FernandoBichuette/projeto-mecat/Anexos/Fotos PCB/Step-Down.jpeg

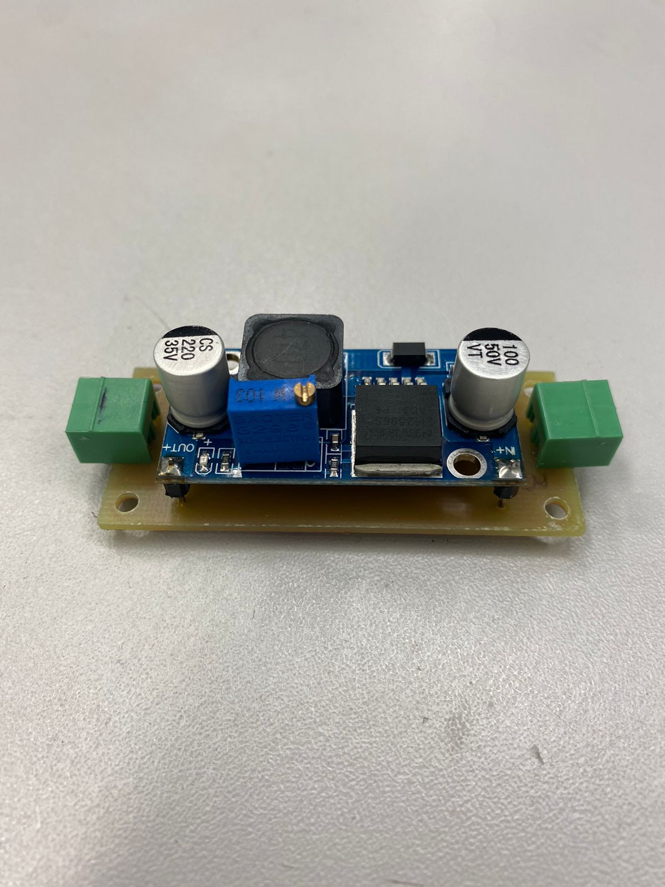
Anexos/Fotos PCB/Step-Down.jpeg
