FernandoBichuette/projeto-mecat/Anexos/Fotos PCB/Lógica Combinacional.jpeg

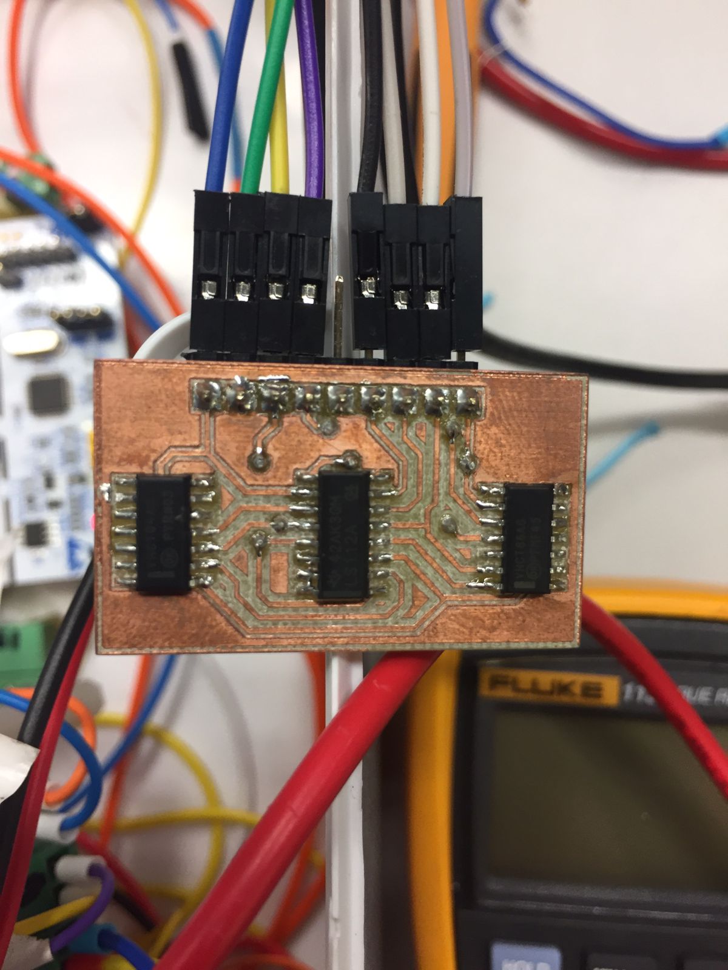
Anexos/Fotos PCB/Lógica Combinacional.jpeg
