FernandoBichuette/projeto-mecat/README.md

  # Projeto Mecatrônico

O projeto mecatrônico da INSPER envolve a criação de uma máquina pipetadora automática destinada a laboratórios, com o intuito de otimizar e tornar mais preciso o processo de pipetagem. A equipe responsável pelo projeto abordou as áreas de Mecânica, Eletrônica e Software para desenvolver um protótipo funcional que atendesse aos requisitos estabelecidos.

Na parte mecânica do projeto, foram realizados cálculos detalhados para o dimensionamento de componentes essenciais, como o fuso de esferas e mancais, guia linear e carro. Esses cálculos foram fundamentais para garantir a correta seleção e integração dos componentes mecânicos, visando a eficiência e durabilidade da máquina pipetadora.

No âmbito eletrônico, o projeto contou com a utilização de diversos elementos, como a placa núcleo com o microcontrolador STM32F103RB, responsável por enviar sinais e alimentar componentes, o debouncing para estabilização de chaves mecânicas, o step-down para conversão de tensão, além dos acionamentos da pipeta e dos motores nos eixos X, Y e Z. Esses componentes eletrônicos foram integrados de forma a garantir o correto funcionamento e controle da máquina.

O desenvolvimento do software do projeto foi baseado em fluxogramas detalhados, que descrevem as operações e funcionalidades da máquina pipetadora. A programação do software foi realizada de acordo com esses fluxogramas, visando a automação e precisão das tarefas executadas pela máquina.

O processo de desenvolvimento do protótipo funcional seguiu as etapas convencionais do processo de desenvolvimento de produto (PDP), envolvendo desde o dimensionamento mecânico e fabricação de peças até o desenvolvimento do projeto eletro-eletrônico, programação de software e implementação da interface homem-máquina.

Em suma, o projeto mecatrônico da INSPER representa um esforço integrado para criar uma máquina pipetadora automática de alta precisão e eficiência, combinando conhecimentos de Mecânica, Eletrônica e Software para atender às demandas de automação no ambiente laboratorial.
