FernandoBichuette/projeto-mecat/Anexos/Fluxogramas e código/codigo fonte.docx

#include "mbed.h"

#include "TextLCD.h"

#include <cstdio>

#include <new>

#include <vector>

// Host PC Communication channels

Serial pc(USBTX, USBRX); // tx, rx

// I2C Communication

I2C i2c_lcd(I2C_SDA, I2C_SCL); // SDA, SCL >>> NUCLEO: D14,D15

//I2C Portexpander PCF8574

TextLCD_I2C lcd(&i2c_lcd, 0x7E, TextLCD::LCD20x4); // I2C bus, PCF8574 Slaveaddress, LCD Type Original = 0x42, Usando I2C scanner = 0x3F

//define quais portas serão usadas e o que farão

DigitalOut clk(PB_15); //step

InterruptIn botao_confirma(PA_11); //botão confirma/verde

InterruptIn botao_chega(PB_6); //botão start cycle/vermelho

InterruptIn botao_emergencia(PA_10); //botão de emergencia

InterruptIn sensor_x_1(PC_9); //sensor de fim de curso em x

DigitalIn x_mais(PB_4); //botão de x+

DigitalIn x_menos(PB_3); //botão de x-

DigitalOut enable_x(PC_5);//enable em x

DigitalOut clkwise_x(PC_6);//direção em x

InterruptIn sensor_y_1(PB_7); //sensor de fim de curso em y

DigitalIn y_mais(PB_10);//botão de y+

DigitalIn y_menos(PA_8);//botão de y-

DigitalOut enable_y(PB_12);//enable em y

DigitalOut clkwise_y(PB_11);//direção em y

InterruptIn sensor_z_1(PA_12); //sensor de fim de curso em y

DigitalIn z_menos(PC_7); //botão de z-

DigitalIn z_mais(PA_9);//botão de z+

DigitalOut enable_z(PB_13);//enable em z

DigitalOut clkwise_z(PB_14);//direção em z

DigitalOut pipeta(PC_4); //pipeta

//Variaveis usadas

int tempo = 950;

int ola;

int quantos_depositos;

int confirma1;

int pote;

int volume;

int index;

int referenciar;

int ciclo;

int fim_referenciamento;

int fc;

int jog;

int ciclo_emergencia;

int voltar_origem;

int curso_x = 49019;

int referenciar_x;

int fonte_x;

int deposito_x=0;

int curso_y=17220;

int referenciar_y;

int fonte_y;

int deposito_y;

int curso_z = 7450;

int referenciar_z;

int fonte_z;

int deposito_z;

int n;

int define_volume;

int define_posicao;

int x1;

int x2;

int x3;

int y1;

int y2;

int y3;

int z1;

int z2;

int z3;

int v1;

int v2;

int v3;

int erro;

void vermelho(){ //Rotina de interrupção que inicializa o ciclo automatico (start cycle)

if(index>1){

ciclo=9;

}

}

void emergencia(){ //Rotina de interrupção da emergencia

erro=!erro;

if(erro==0){

NVIC_SystemReset(); //reseta o programa

}

}

void fim_de_curso_z_1(){ //Rotina de interrupção do fim de curso em z

switch (fc) {

case 0:

referenciar=2;

clkwise_z=0;

for(int i=0;i<400;i++){

enable_z=0;

clk=!clk;

wait_us(tempo);

}

fc++;

enable_z=1;

break;

}

switch (ciclo) {

case 0:

enable_x=1;

enable_y=1;

enable_z=0;

for(int i=0;i<400;i++){

clkwise_z=1;

clk=!clk;

wait_us(tempo);

}

break;

}

}

void fim_de_curso_y_1(){ //Rotina de interrupção do fim de curso em y

switch (fc) {

case 1:

referenciar=3;

clkwise_y=0;

for(int i=0;i<400;i++){

clk=!clk;

wait_us(tempo);

}

fc++;

enable_y=1;

break;

}

switch (ciclo) {

case 0:

enable_y=0;

enable_x=1;

clkwise_y=1;

for(int i=0;i<400;i++){

clkwise_y=0;

clk=!clk;

wait_us(tempo);

}

break;

}

}

void fim_de_curso_x_1(){ //Rotina de interrupção do fim de curso em x

switch (fc) {

case 2:

referenciar=4;

clkwise_x=1;

for(int i=0;i<400;i++){

enable_x=0;

clk=!clk;

wait_us(tempo);

}

fc++;

fim_referenciamento=1;

enable_x=1;

break;

}

switch (ciclo) {

case 0:

enable_y=1;

enable_x=0;

for(int i=0;i<400;i++){

clkwise_x=1;

clk=!clk;

wait_us(tempo);

}

break;

}

}

void confirma(){ //Rotina de interrupção do botão de confirmação

if (referenciar==0){

referenciar=1;

ciclo = 1;

}

if (fim_referenciamento==1){

referenciar=0;

ciclo=2;

}

if (jog ==1){

ciclo=3;

}

if(define_volume==1){

ciclo=4;

}

if(define_volume==2){

ciclo=5;

}

if(define_volume==3){

ciclo=6;

}

if(define_volume==4){

ciclo=7;

}

if(define_volume==5){

ciclo=8;

}

if(define_volume==6){

ciclo=9;

}

}

int main(){

//define em quais funções os botoes vão entrar

botao_confirma.fall(&confirma);

botao_chega.fall(&vermelho);

botao_emergencia.rise(&emergencia);

sensor_x_1.fall(&fim_de_curso_x_1);

sensor_y_1.fall(&fim_de_curso_y_1);

sensor_z_1.fall(&fim_de_curso_z_1);

//liga o lcd

lcd.setBacklight(TextLCD::LightOn);

//inicia o programas com os motores desligados

enable_x=1;

enable_y=1;

enable_z=1;

volume = 0;

pipeta =1;

while(1){//loop principal

switch(erro){

case 1:

while(erro==1){ //loop para aparecer no lcd a messagem emergencia, caso botão do acionado

lcd.cls();

lcd.locate(4,2);

lcd.printf("Emergencia");

wait(3);

}

break;

}

switch (ciclo) { //Ciclo do programa do ciclo total

case 0:

while(ciclo==0 && jog==0){ //loop para aparecer no lcd a messagem de intruções iniciais

lcd.cls();

wait_us(10);

lcd.cls();

lcd.locate(8,1);

lcd.printf("Ola");

wait(3);

lcd.cls();

wait_us(10);

lcd.cls();

lcd.locate(3,1);

lcd.printf("Aperte confirma");

lcd.locate(3,2);

lcd.printf("para iniciar o");

lcd.locate(3,3);

lcd.printf("referenciamento");

wait(4);

}

break;

case 1: // rotina de referenciamento em todos os eixos

lcd.cls();

wait_us(10);

lcd.cls();

lcd.locate(2,1);

lcd.printf("Referenciando...");

switch (referenciar) {

case 1:

enable_z=0;

clkwise_z=1;

while(referenciar==1){

clk=!clk;

wait_us(tempo);

}

break;

case 2:

enable_y=0;

clkwise_y=1;

while(referenciar==2){

clk=!clk;

wait_us(tempo);

}

break;

case 3:

enable_x=0;

clkwise_x=0;

while(referenciar==3){

clk=!clk;

wait_us(tempo);

}

break;

case 4:

while(referenciar==4){

lcd.cls();

wait_us(10);

lcd.cls();

lcd.locate(2,1);

lcd.printf("Referenciamento");

lcd.locate(5,2);

lcd.printf("concluido");

wait(3);

lcd.cls();

wait_us(10);

lcd.cls();

lcd.locate(3,1);

lcd.printf("Aperte confirma");

lcd.locate(2,2);

lcd.printf("para definir a");

lcd.locate(8,3);

lcd.printf("fonte");

wait(3);

}

break;

}

break;

case 2: //Rotina de jog para fonte/reservatorio de liquido

while(ciclo==2){

jog=1;

enable_x=1;

enable_y=1;

enable_z=1;

lcd.cls();

lcd.locate(2,1);

lcd.printf("Fonte X %i",fonte_x);

lcd.locate(2,2);

lcd.printf("Fonte Y %i",fonte_y);

lcd.locate(2,3);

lcd.printf("Fonte Z %i",fonte_z);

wait(0.4);

while(x_mais==0){

if(fonte_x<curso_x){

enable_x=0;

fonte_x++;

clkwise_x=1;

clk=!clk;

wait_us(tempo);

}

else{

enable_x=1;

}

}

while(x_menos==0){

if(fonte_x>0){

enable_x=0;

fonte_x--;

clkwise_x=0;

clk=!clk;

wait_us(tempo);

}

else{

enable_x=1;

}

}

while(y_mais==0){

if(fonte_y<curso_y){

enable_y=0;

fonte_y++;

clkwise_y=0;

clk=!clk;

wait_us(tempo);

}

else{

enable_y=1;

}

}

while(y_menos==0){

if(fonte_y>0){

enable_y=0;

fonte_y--;

clkwise_y=1;

clk=!clk;

wait_us(tempo);

}

else{

enable_y=1;

}

}

//

while(z_menos==0){

if(fonte_z<curso_z){

enable_z=0;

fonte_z++;

clkwise_z=0;

clk=!clk;

wait_us(tempo);

}

else{

enable_z=1;

}

}

while(z_mais==0){

if(fonte_z>0){

enable_z=0;

fonte_z--;

clkwise_z=1;

clk=!clk;

wait_us(tempo);

}

else{

enable_z=1;

}

}

}

break;

case 3:

if(voltar_origem == 0){ //rotina para que depois de definido qual posição da fonte/reservatorio, maquina volta para origem

lcd.cls();

lcd.locate(3,1);

lcd.printf("Voltando para");

lcd.locate(5,2);

lcd.printf("a origem");

for(int z=0; z<(fonte_z);z++){

enable_x=1;

enable_y=1;

enable_z=0;

clkwise_z=1;

clk=!clk;

wait_us(tempo);

}

for(int x=0; x<(fonte_x);x++){

enable_x=0;

enable_y=1;

enable_z=1;

clkwise_x=0;

clk=!clk;

wait_us(tempo);

}

for(int y=0; y<(fonte_y);y++){

enable_x=1;

enable_y=0;

enable_z=1;

enable_y=0;

clkwise_y=1;

clk=!clk;

wait_us(tempo);

}

voltar_origem=1;

}

if (voltar_origem==1){ //rotina para definir volume no pote 1

lcd.cls();

lcd.locate(3,1);

lcd.printf("Defina o volume");

lcd.locate(3,2);

lcd.printf("no pote %i",index);

lcd.locate(3,3);

lcd.printf("%i ml",v1);

index++;

define_volume++;

while(ciclo==3){ //loop para definir volume no pote 1

lcd.cls();

lcd.locate(3,1);

lcd.printf("Defina o volume");

lcd.locate(3,2);

lcd.printf("no pote %i",index);

lcd.locate(3,3);

lcd.printf("%i ml",v1);

wait(0.8);

while(z_mais==0){

v1++;

wait(0.2);

}

while(z_menos==0){

if(v1>=0){

v1--;

wait(0.2);

}

}

}

}

break;

////

case 4: //rotina para definir posição do pote 1

lcd.cls();

wait_us(10);

lcd.cls();

lcd.locate(3,1);

lcd.printf("Deposito X %i",x1);

lcd.locate(3,2);

lcd.printf("Deposito Y %i",y1);

lcd.locate(3,3);

lcd.printf("Deposito Z %i",z1);

define_volume++;

while(ciclo==4){

enable_x=1;

enable_y=1;

enable_z=1;

lcd.cls();

wait_us(10);

lcd.cls();

lcd.locate(3,1);

lcd.printf("Deposito X %i",x1);

lcd.locate(3,2);

lcd.printf("Deposito Y %i",y1);

lcd.locate(3,3);

lcd.printf("Deposito Z %i",z1);

wait(0.8);

while(x_mais==0){

if(x1<curso_x){

enable_x=0;

clkwise_x=1;

x1 ++;

clk=!clk;

wait_us(tempo);

}

else{

enable_x=1;

}

}

while(x_menos==0){

if(x1>0){

enable_x=0;

clkwise_x=0;

x1--;

clk=!clk;

wait_us(tempo);

}

else{

enable_x=1;

}

}

while(y_mais==0){

if(y1<curso_y){

enable_y=0;

clkwise_y=0;

y1 ++;

clk=!clk;

wait_us(tempo);

}

else{

enable_y=1;

}

}

while(y_menos==0){

if(y1>0){

enable_y=0;

clkwise_y=1;

y1--;

clk=!clk;

wait_us(tempo);

}

else{

enable_y=1;

}

}

while(z_menos==0){

if(z1<curso_z){

enable_z=0;

clkwise_z=0;

z1 ++;

clk=!clk;

wait_us(tempo);

}

else{

enable_z=1;

}

}

while(z_mais==0){

if(z1>0){

enable_z=0;

clkwise_z=1;

z1--;

clk=!clk;

wait_us(tempo);

}

else{

enable_z=1;

}

}

}

break;

case 5: //rotina para definir volume no pote 2

lcd.cls();

lcd.locate(3,1);

lcd.printf("Defina o volume");

lcd.locate(3,2);

lcd.printf("no pote %i",index);

lcd.locate(3,3);

lcd.printf("%i ml",v2);

index++;

define_volume++;

while(ciclo==5){

lcd.cls();

lcd.locate(3,1);

lcd.printf("Defina o volume");

lcd.locate(3,2);

lcd.printf("no pote %i",index);

lcd.locate(3,3);

lcd.printf("%i ml",v2);

wait(0.8);

while(z_mais==0){

v2++;

wait(0.2);

}

while(z_menos==0){

if(v2>=0){

v2--;

wait(0.2);

}

}

}

break;

////

case 6: //rotina para definir posição do pote 2

x2=x1;

y2=y1;

z2=z1;

lcd.cls();

wait_us(10);

lcd.cls();

lcd.locate(3,1);

lcd.printf("Deposito X %i",x2);

lcd.locate(3,2);

lcd.printf("Deposito Y %i",y2);

lcd.locate(3,3);

lcd.printf("Deposito Z %i",z2);

define_volume++;

while(ciclo==6){

enable_x=1;

enable_y=1;

enable_z=1;

lcd.cls();

wait_us(10);

lcd.cls();

lcd.locate(3,1);

lcd.printf("Deposito X %i",x2);

lcd.locate(3,2);

lcd.printf("Deposito Y %i",y2);

lcd.locate(3,3);

lcd.printf("Deposito Z %i",z2);

wait(0.8);

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

enable_x=0;

enable_y=1;

enable_z=1;

if ((fonte_x-x1)<0){

clkwise_x=1;

}

else{

clkwise_x=0;

}

clk=!clk;

wait_us(tempo);

}

wait(0.2);

for(int n=0;n<=abs(fonte_y-y1);n++){

enable_x=1;

enable_y=0;

enable_z=1;

if ((fonte_y-y1)<0){

clkwise_y=0;

}

else{

clkwise_y=1;

}

clk=!clk;

wait_us(tempo);

}

wait(0.2);

for(int n=0;n<=z1;n++){

enable_x=1;

enable_y=1;

enable_z=0;

clkwise_z=0;

clk=!clk;

wait_us(tempo);

}

wait(0.2);

pipeta=!pipeta; //aciona a pipeta

wait(4);

for(int n=0;n<=z1;n++){

enable_x=1;

enable_y=1;

enable_z=0;

clkwise_z=1;

clk=!clk;

wait_us(tempo);

//pipeta=!pipeta;

}

wait(0.2);

for(int n=0;n<=abs(fonte_x-x1);n++){

enable_x=0;

enable_y=1;

enable_z=1;

if ((fonte_x-x1)<0){

clkwise_x=1;

}

else{

clkwise_x=0;

}

clk=!clk;

wait_us(tempo);

}

wait(0.2);

for(int n=0;n<=abs(fonte_y-y1);n++){

enable_x=1;

enable_y=0;

enable_z=1;

if ((fonte_y-y1)<0){

clkwise_y=0;

}

else{

clkwise_y=1;

}

clk=!clk;

wait_us(tempo);

}

wait(0.2);

}

}

//messagem de ciclo concluido

lcd.cls();

wait_us(10);

lcd.cls();

lcd.locate(3,1);

lcd.printf("Ciclo");

lcd.locate(3,2);

lcd.printf("Concluido");

wait(0.5);

break;

}

}

}
