FernandoBichuette/projeto-mecat/Anexos/Desenhos Técnicos/Desenho técnico botão.jpg

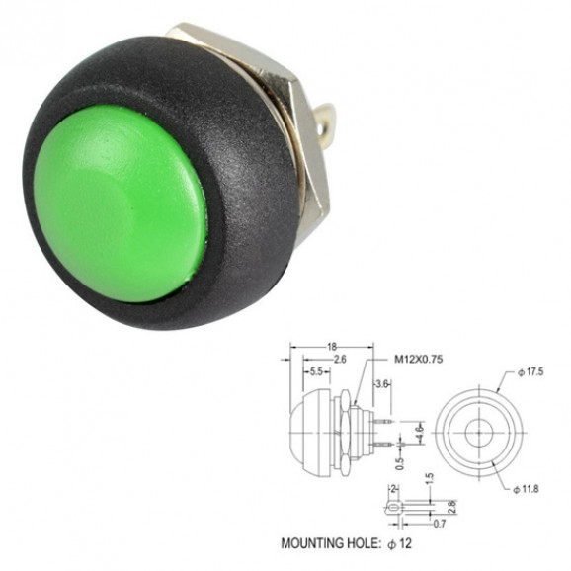
Anexos/Desenhos Técnicos/Desenho técnico botão.jpg
