FernandoBichuette/projeto-mecat/Anexos/Desenhos Técnicos/Desenho Técnico Chave fim de curso.png

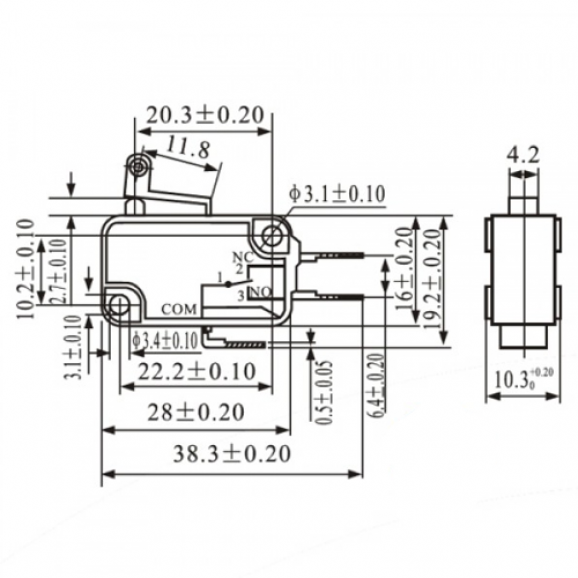
Anexos/Desenhos Técnicos/Desenho Técnico Chave fim de curso.png
