FernandoBichuette/projeto-mecat/Anexos/Fixação da pipeta.jpeg

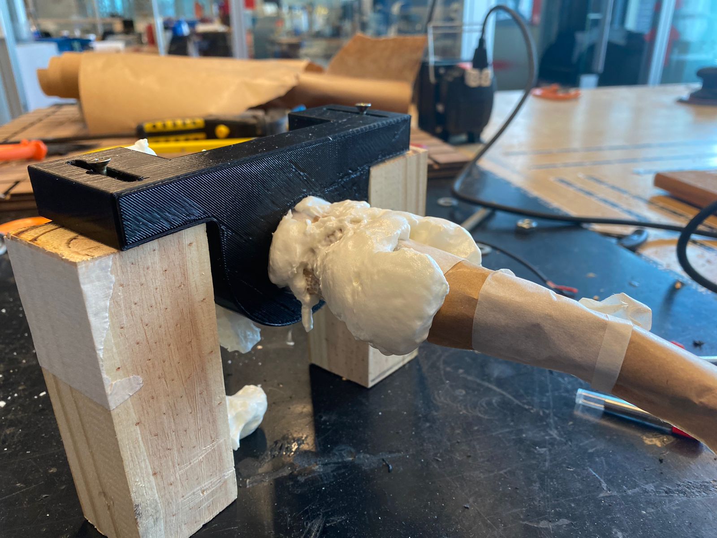
Anexos/Fixação da pipeta.jpeg
