FernandoBichuette/projeto-mecat/Anexos/Fluxogramas e código/Botão de emergência.png

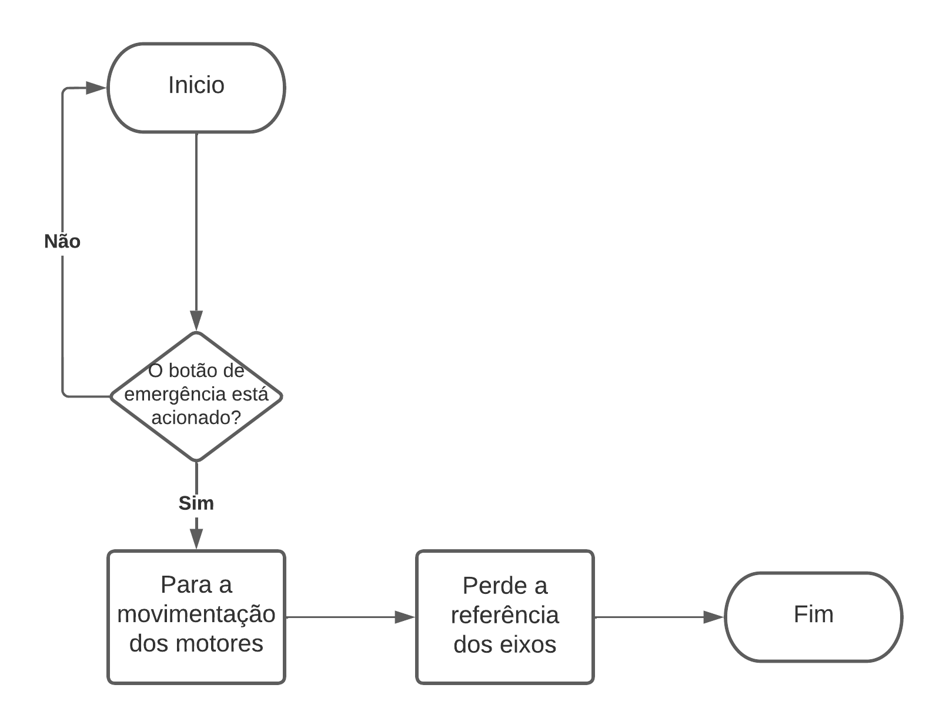
Anexos/Fluxogramas e código/Botão de emergência.png
