FernandoBichuette/projeto-mecat/Anexos/Fluxogramas e código/Ciclo automatico.png

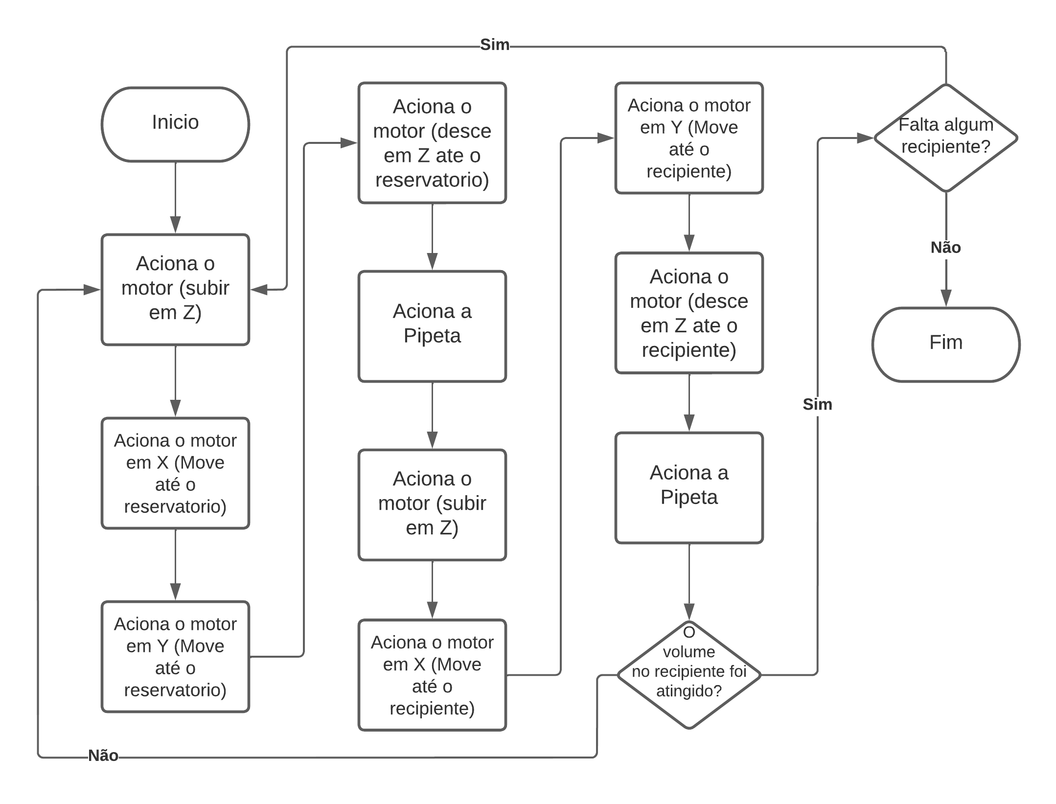
Anexos/Fluxogramas e código/Ciclo automatico.png
