FernandoBichuette/projeto-mecat/Anexos/Fluxogramas e código/Fluxograma Definição de volume.png

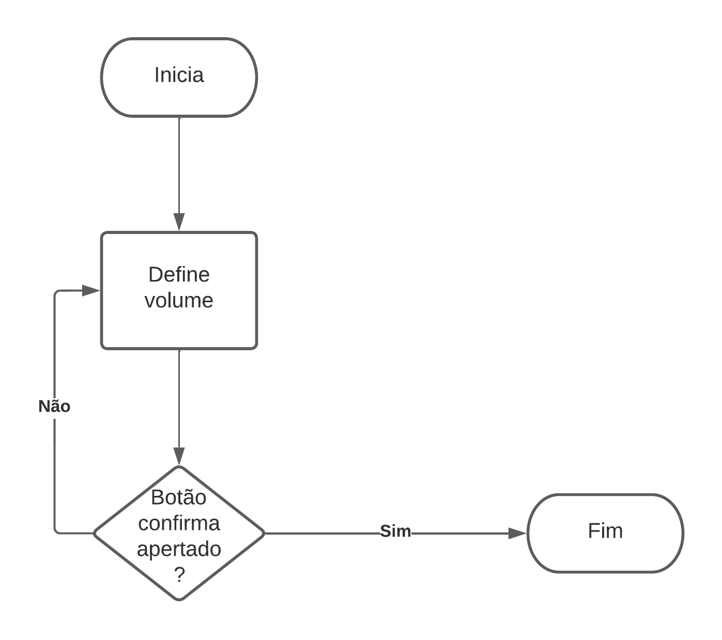
Anexos/Fluxogramas e código/Fluxograma Definição de volume.png
