FernandoBichuette/projeto-mecat/Anexos/Fluxogramas e código/Fluxograma Jog deposito.png

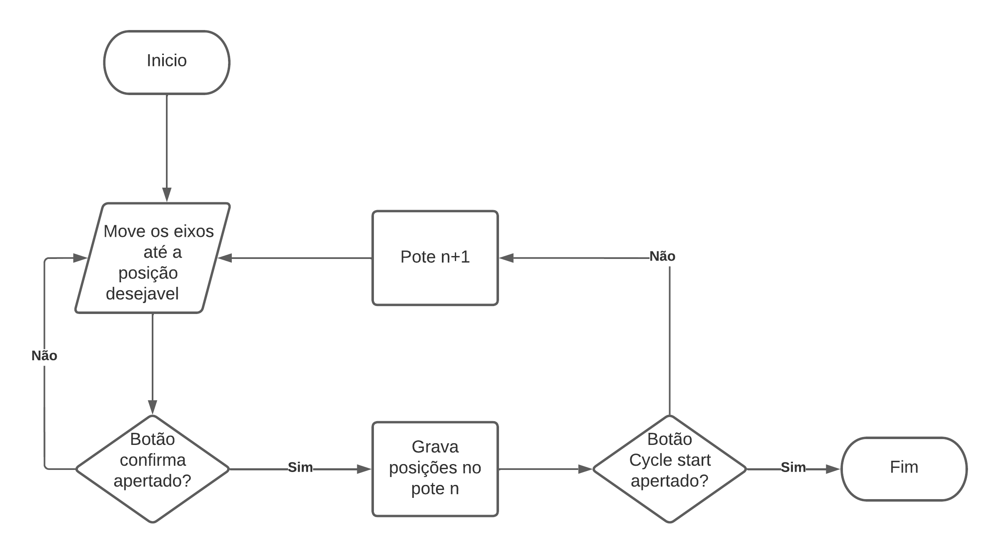
Anexos/Fluxogramas e código/Fluxograma Jog deposito.png
