FernandoBichuette/projeto-mecat/Anexos/Fluxogramas e código/Fluxograma Jog fonte.png

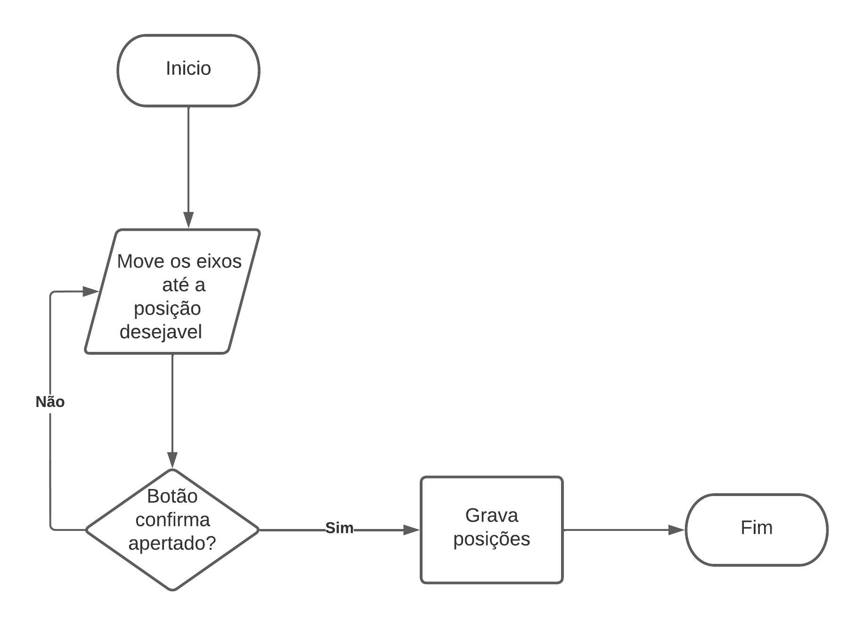
Anexos/Fluxogramas e código/Fluxograma Jog fonte.png
