FernandoBichuette/projeto-mecat/Anexos/Fluxogramas e código/Fluxograma Referenciamento.png

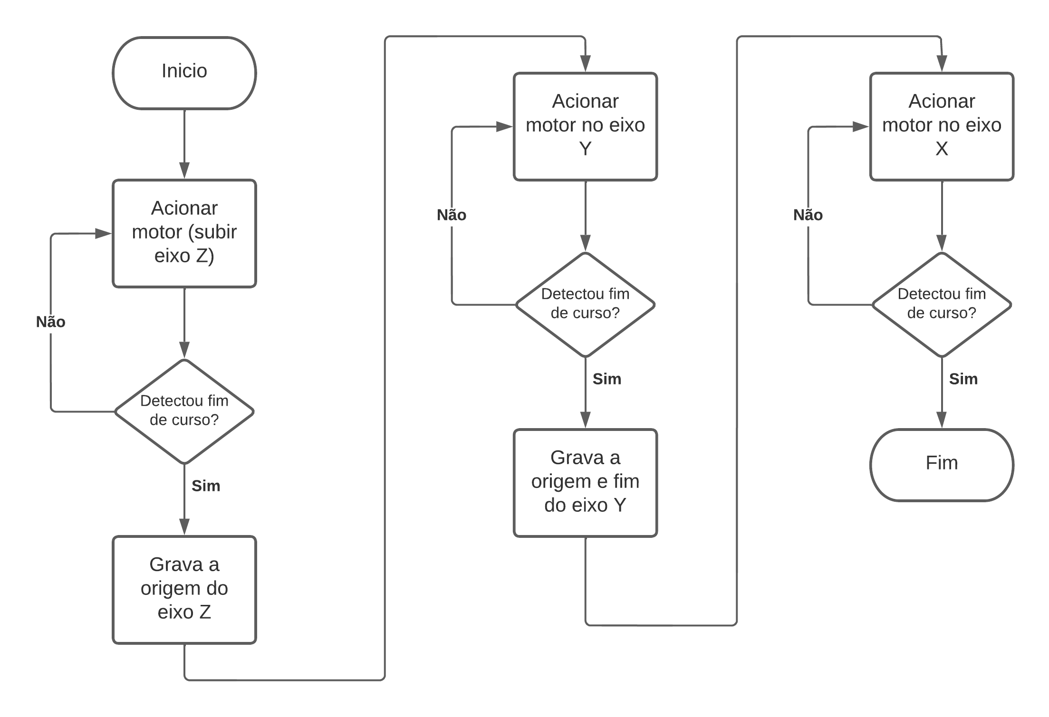
Anexos/Fluxogramas e código/Fluxograma Referenciamento.png
