FernandoBichuette/projeto-mecat/Anexos/Fotos PCB/Circuito de Potencia.jpeg

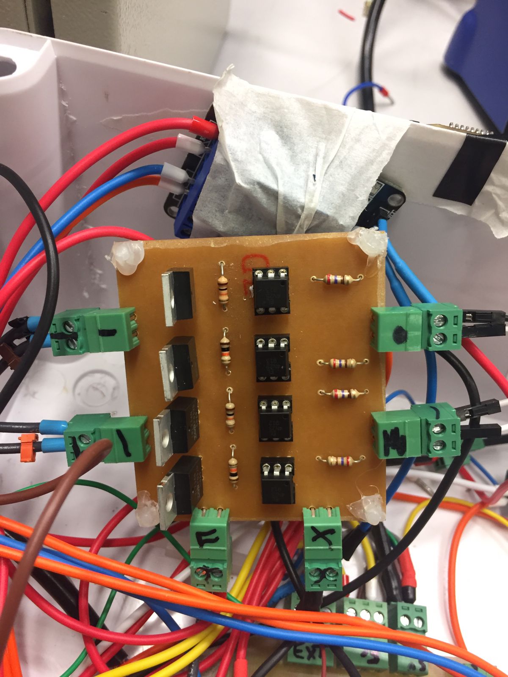
Anexos/Fotos PCB/Circuito de Potencia.jpeg
