FernandoBichuette/projeto-mecat/Anexos/Fotos PCB/Debouncing.jpeg

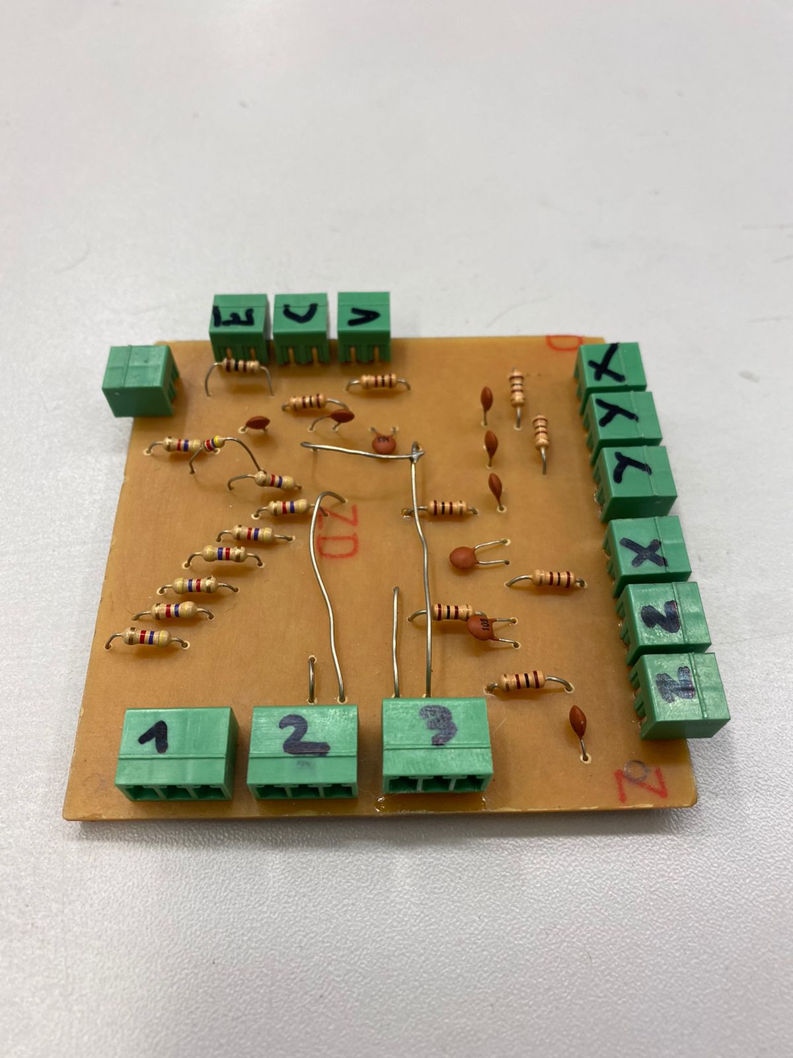
Anexos/Fotos PCB/Debouncing.jpeg
