FernandoBichuette/projeto-mecat/Anexos/Fotos PCB/Nucleo .jpeg

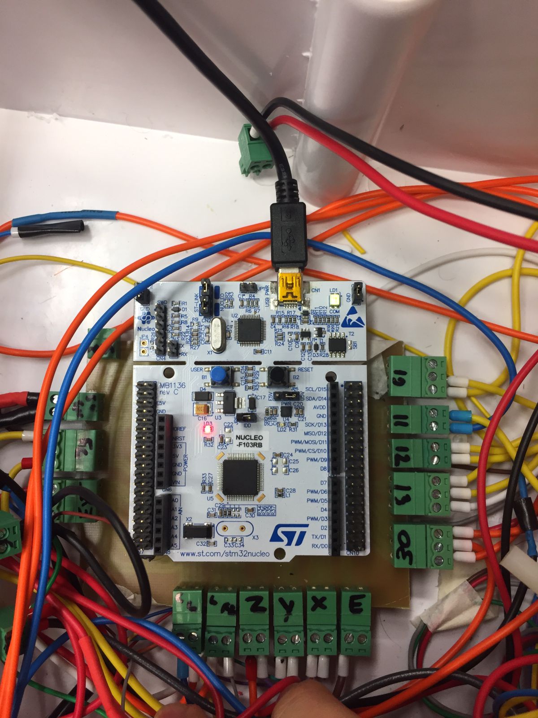
Anexos/Fotos PCB/Nucleo .jpeg
