FernandoBichuette/projeto-mecat/Anexos/Desenhos Técnicos/Base_suporte_pipeta.pdf

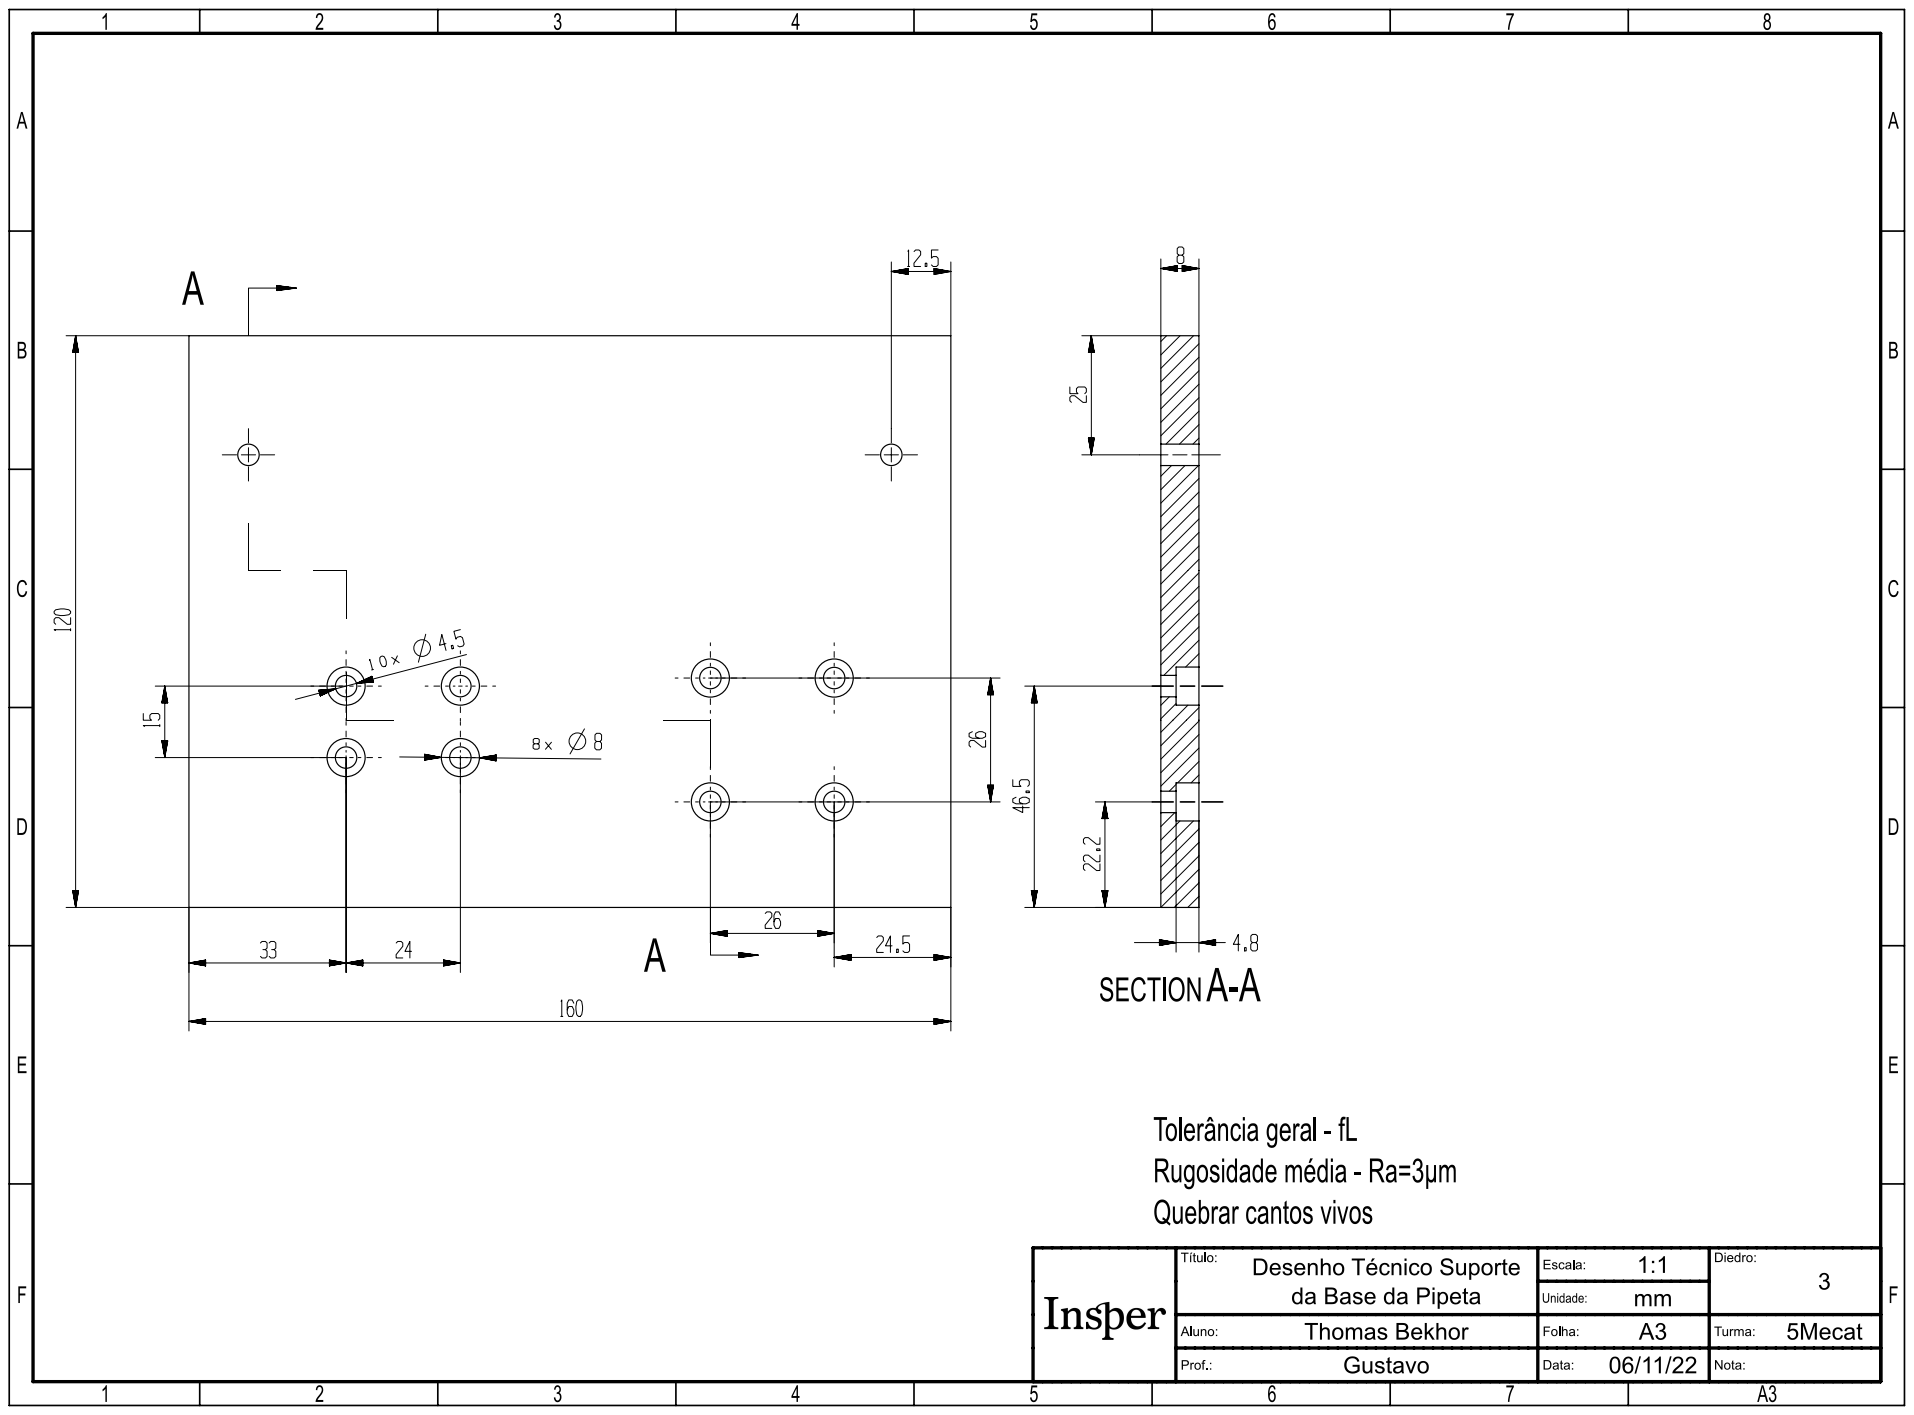
[picture p15: page 1]
