FernandoBichuette/projeto-mecat/Anexos/Desenhos Técnicos/batente.pdf

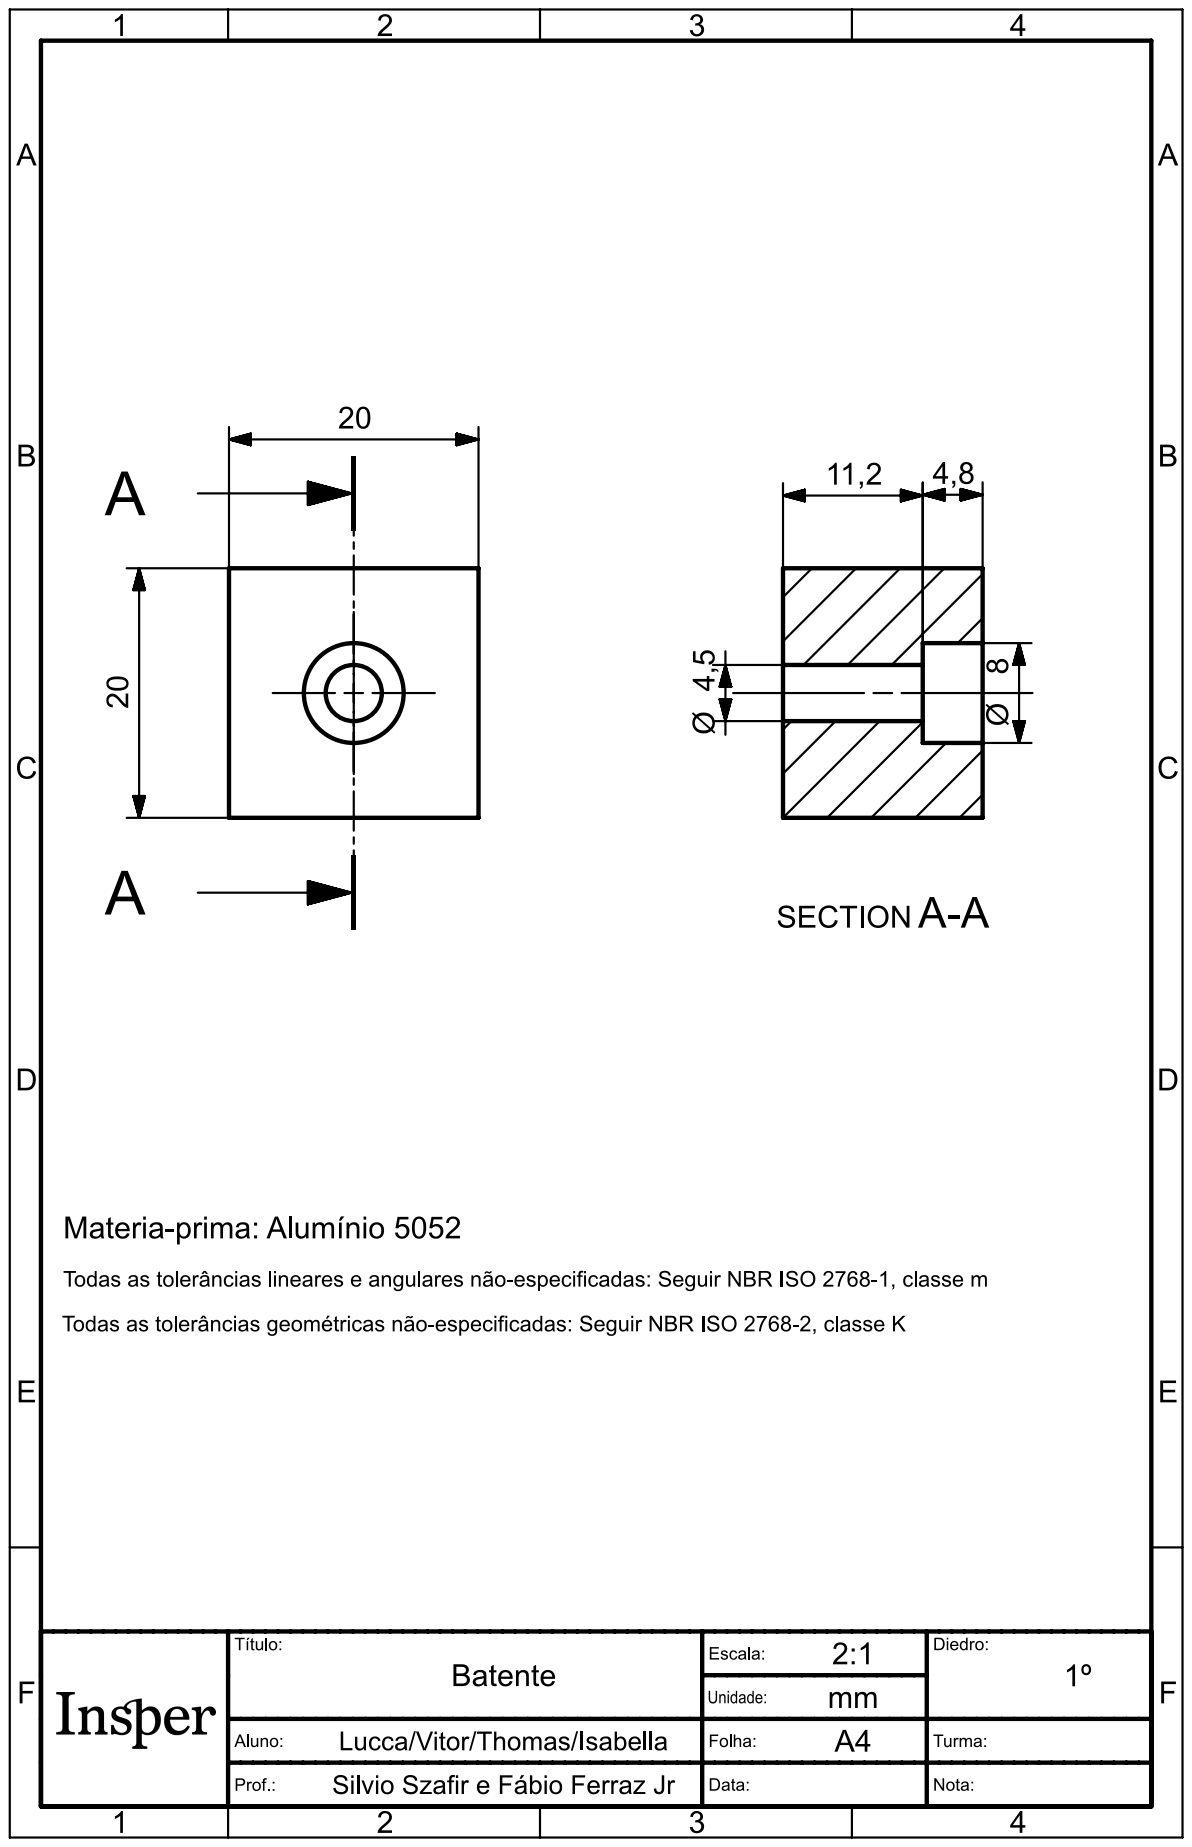
[picture p16: page 1]
