FernandoBichuette/projeto-mecat/Anexos/Desenhos Técnicos/Desenho Técnico Suporte Motor.pdf

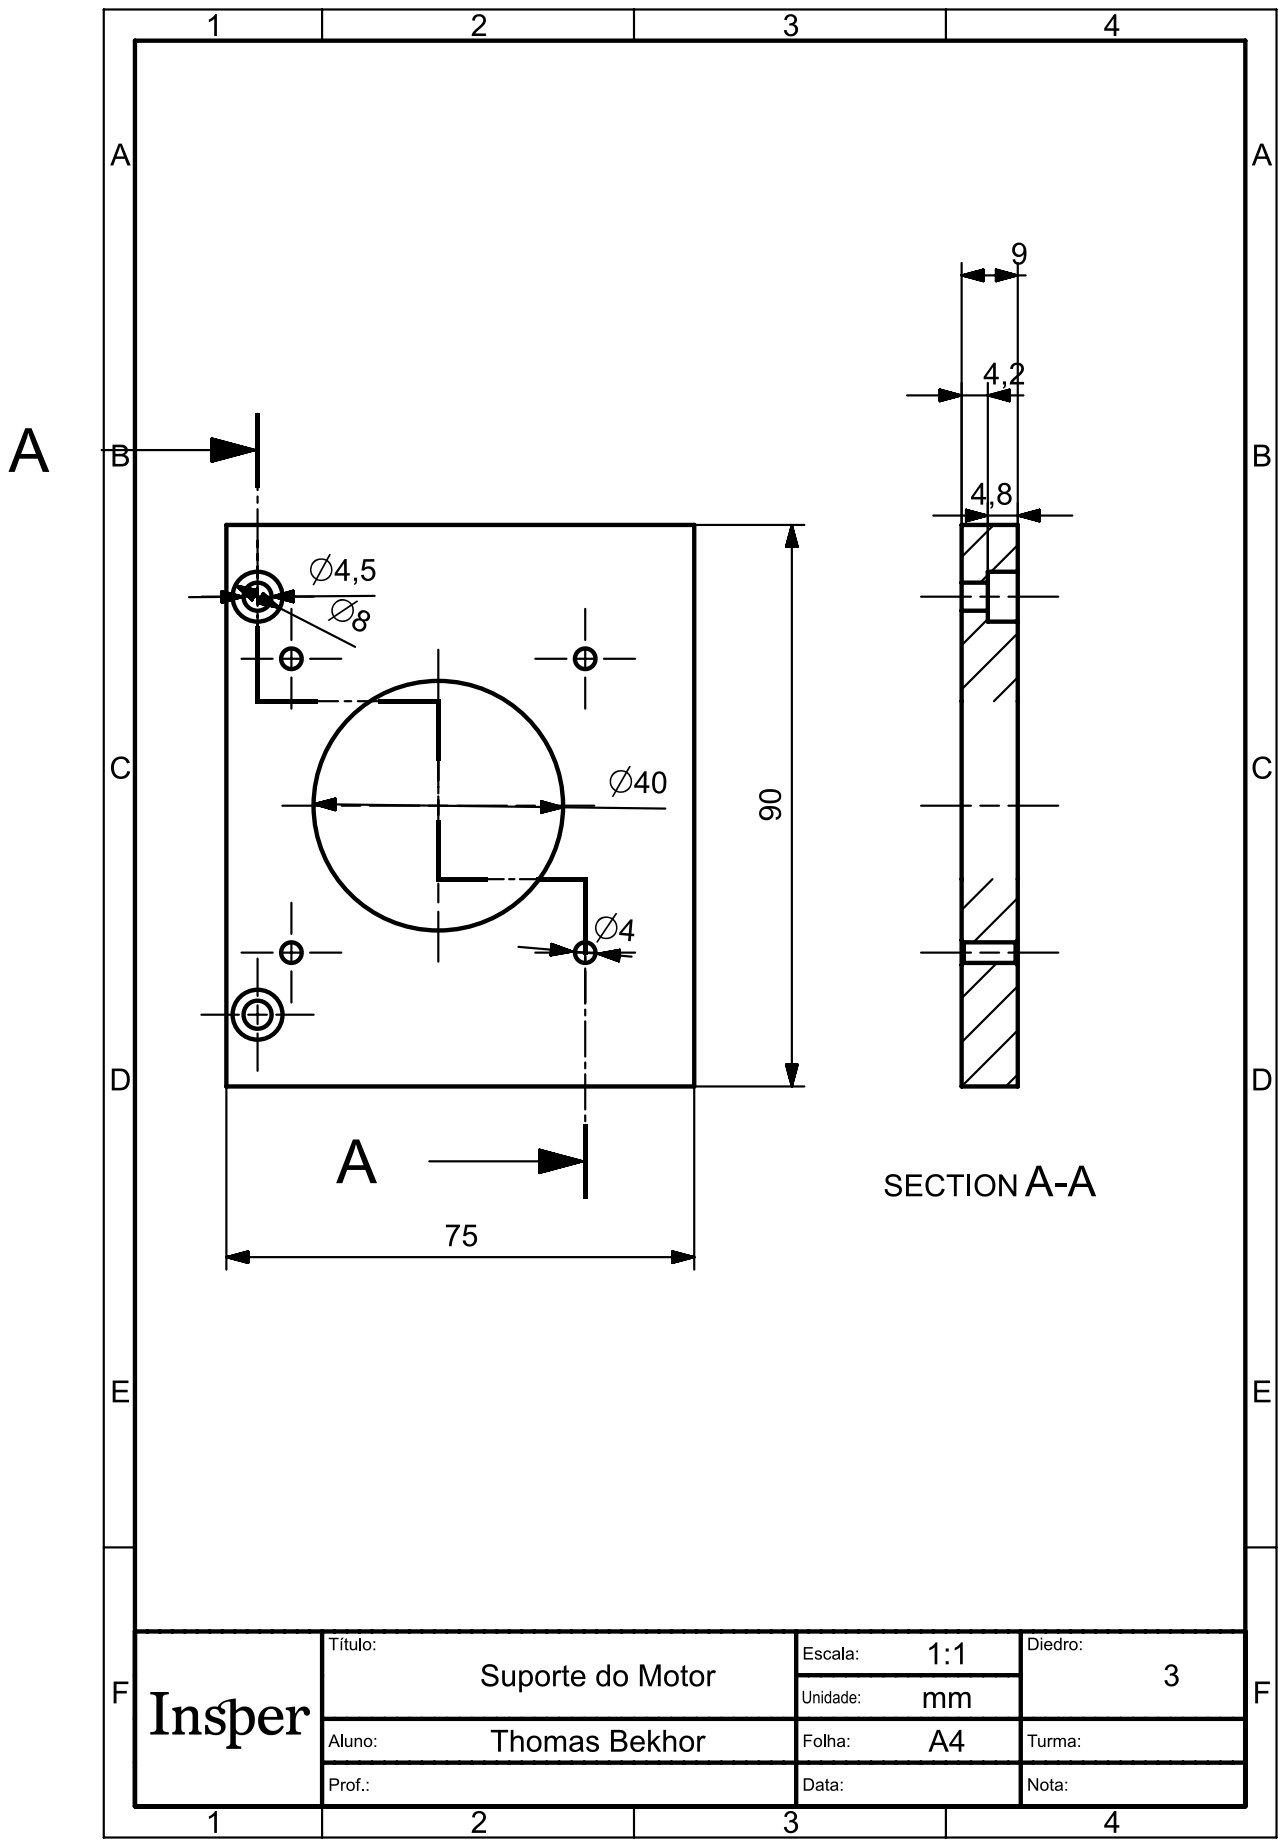
[picture p17: page 1]
