FernandoBichuette/projeto-mecat/Anexos/Desenhos Técnicos/Desenho_base.pdf

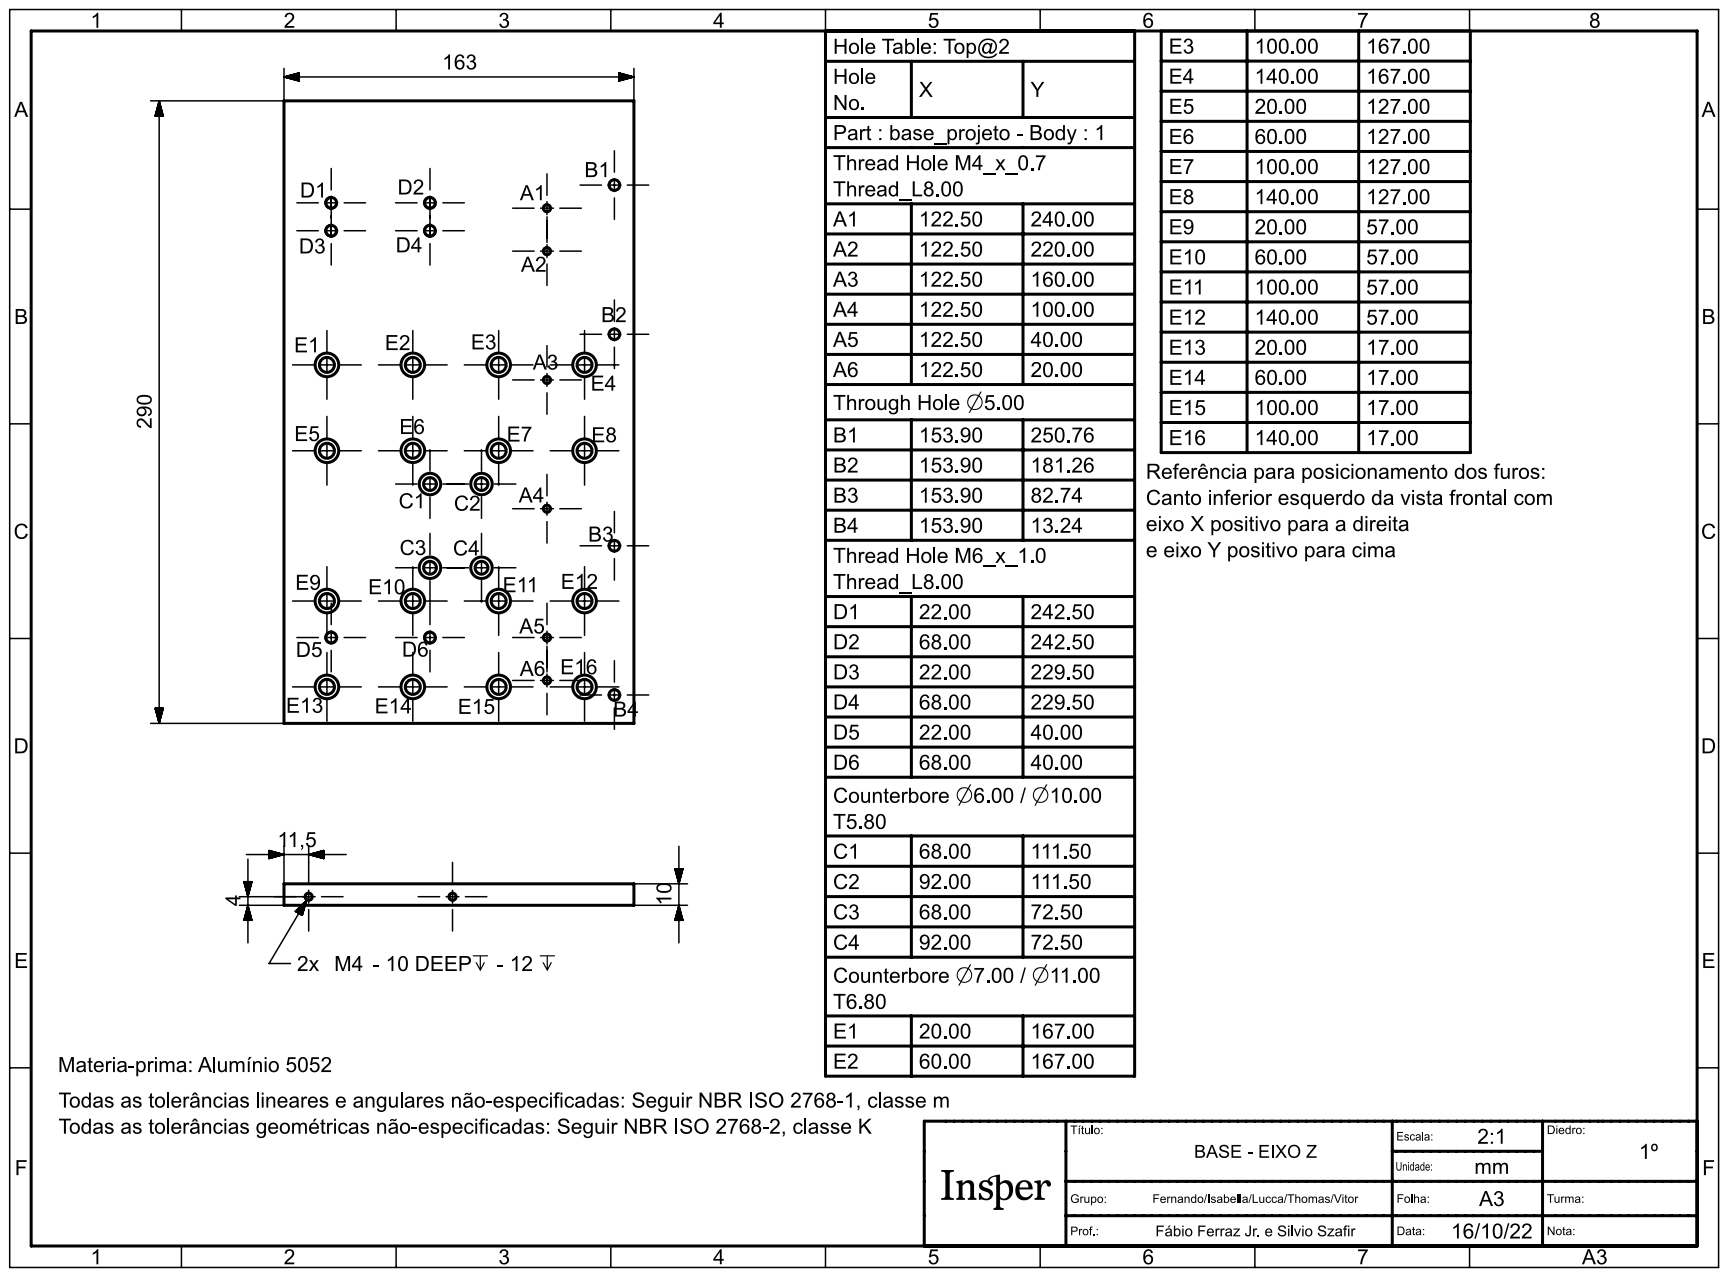
[picture p18: page 1]
