FernandoBichuette/projeto-mecat/Anexos/Desenhos Técnicos/Suporte Castanha.pdf

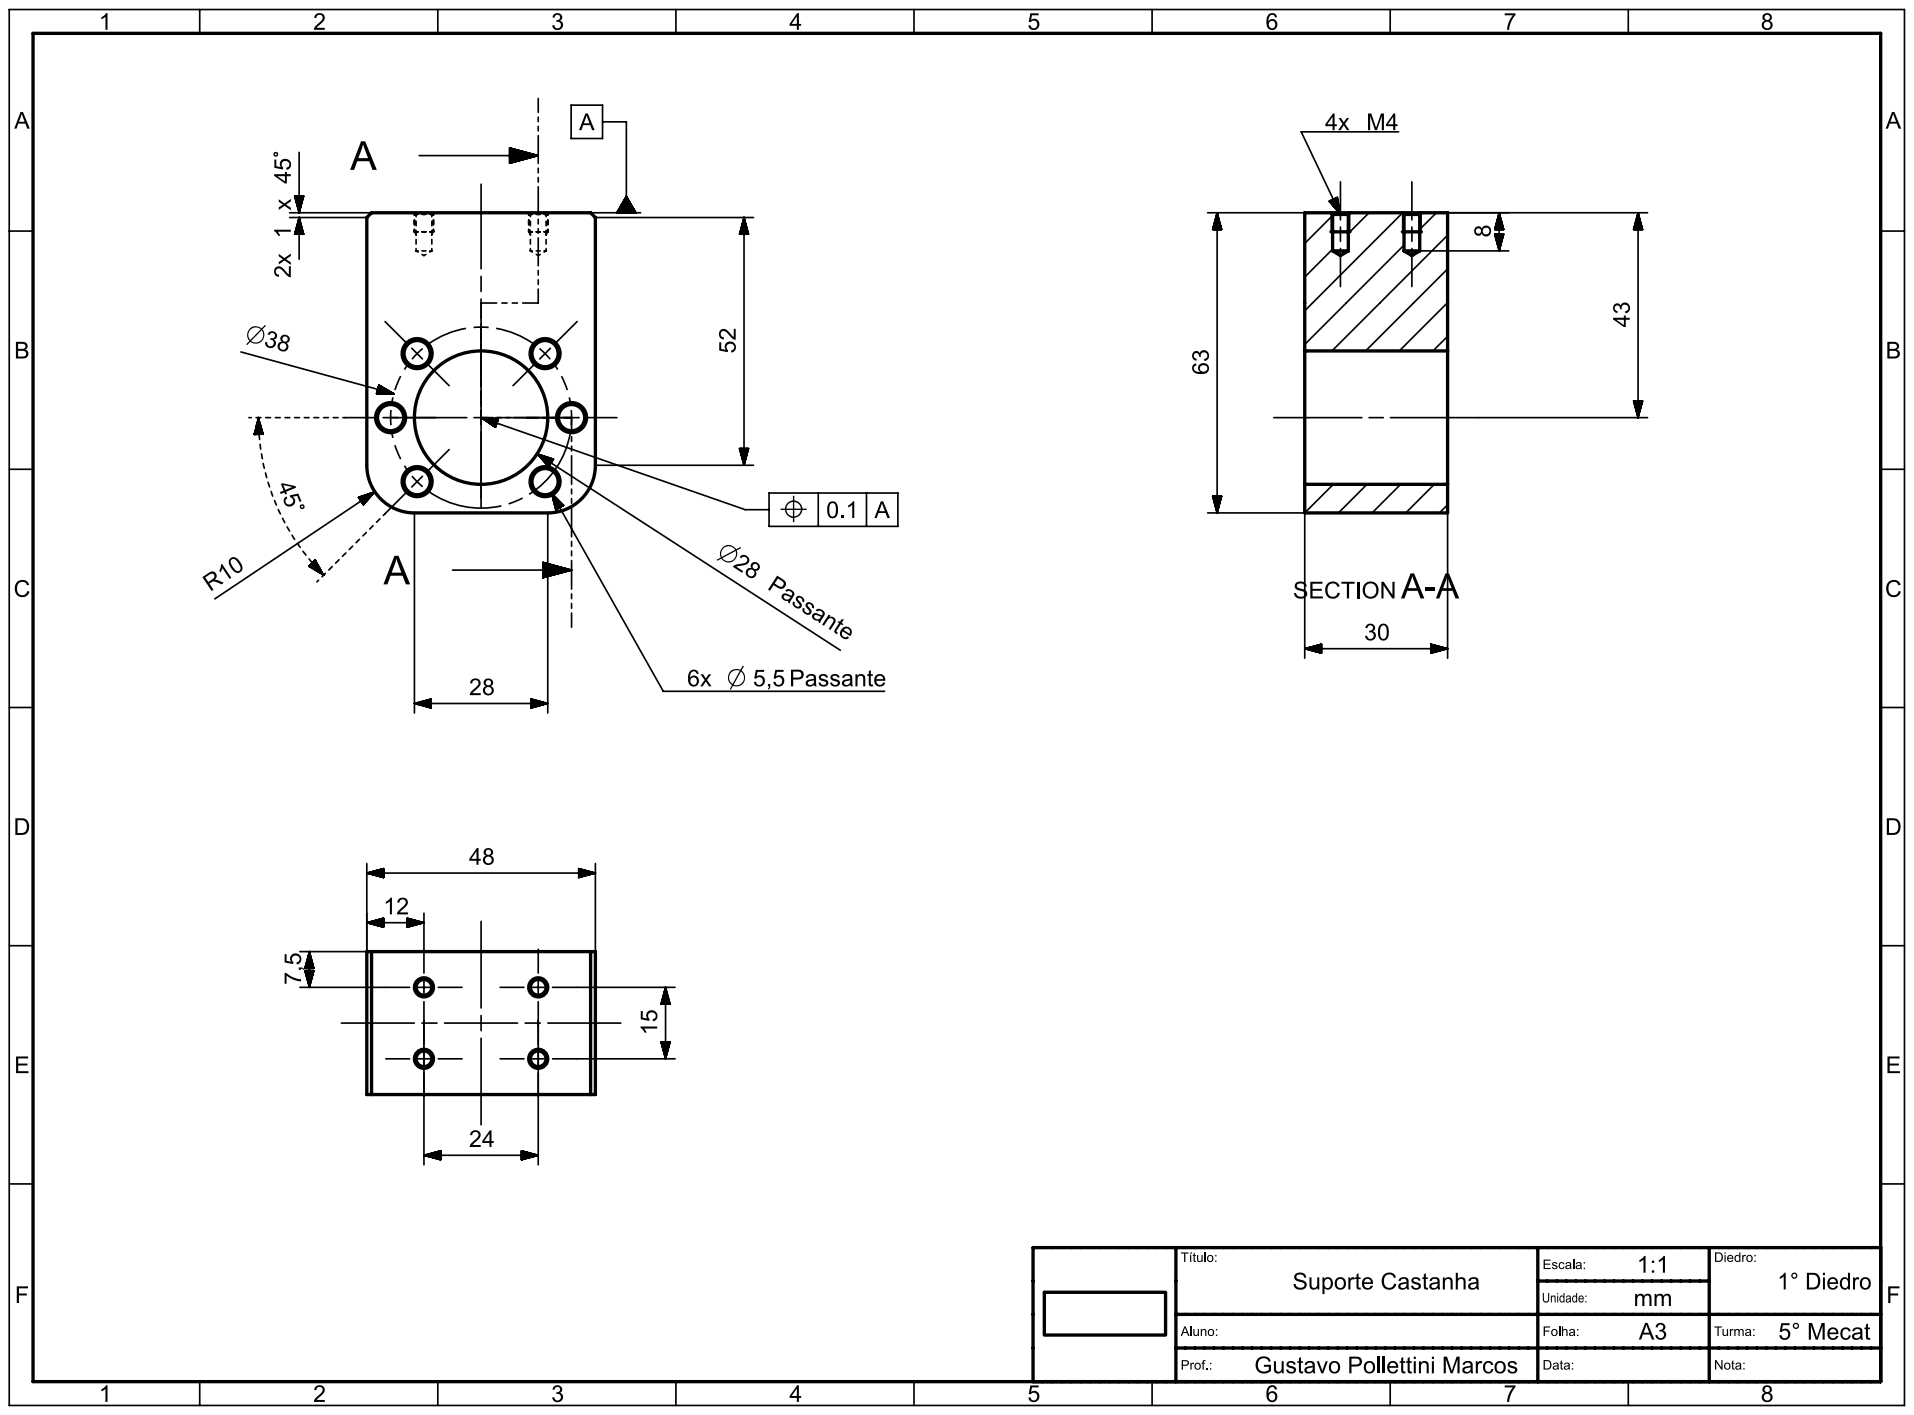
[picture p19: page 1]
