FernandoBichuette/projeto-mecat/(list of files, cad)

Other CAD files:
Anexos/Montagem 3D/Acoplamento.prt
Anexos/Montagem 3D/BF12.prt
Anexos/Montagem 3D/BK12.prt
Anexos/Montagem 3D/Calço do Guia.prt
Anexos/Montagem 3D/Castanha.prt
Anexos/Montagem 3D/FIM_DE_CURSO.prt
Anexos/Montagem 3D/Fuso.prt
Anexos/Montagem 3D/Montagem fim de curso.prt
Anexos/Montagem 3D/Montagem fuso de esferas.prt
Anexos/Montagem 3D/Montagem.prt
Anexos/Montagem 3D/Motor.prt
Anexos/Montagem 3D/Patinho.prt
Anexos/Montagem 3D/Suporte Pipeta.prt
Anexos/Montagem 3D/Suporte_do_sensor_fim_de_curso 2.prt
Anexos/Montagem 3D/Suporte_do_sensor_fim_de_curso 3.prt
Anexos/Montagem 3D/Suporte_do_sensor_fim_de_curso.prt
Anexos/Montagem 3D/Trilho.prt
Anexos/Montagem 3D/base_projeto.prt
Anexos/Montagem 3D/basesuportepipeta.prt
Anexos/Montagem 3D/batente.prt
Anexos/Montagem 3D/montagem fim de curso 2.prt
Anexos/Montagem 3D/montagem guia linear.prt
Anexos/Montagem 3D/suportemotor.prt
